koreyoshi-zzz/CRTC2026-SuiYuan/media/README.md

# 媒体素材

本目录存放考核演示视频。文档 `docs/CRTC2026_中期考核技术文档.md` 第 5 章的各功能板块通过相对路径引用本目录文件。

## 当前文件

| 文件名 | 内容说明 | 分辨率 | 帧率 | 时长 | 大小 | 是否达标 |
| --- | --- | --- | --- | --- | --- | --- |
| `chassis_ps2.mp4` | PS2 手柄遥控底盘（5.6 底盘运动） | 1920×1080 | 30 fps | 12.8 s | 13.6 MB | ✅ 达标 |
| `drop_test.mp4` | 180 mm 自由落体跌落测试（5.11 结构稳定性） | 2560×1440 | 120 fps | 20.9 s | 44.6 MB | ✅ 达标 |
| `appearance_360.mp4` | 整车外形展示 / 绕车一周（5.1） | 1584×720 | 25 fps | 10.0 s | 4.5 MB | ⚠️ 720p/25fps |
| `servo_demo.mp4` | 舵机运动演示（5.4 单一 / 5.5 多项共用） | 1584×720 | 25 fps | 14.9 s | 5.9 MB | ⚠️ 720p/25fps |
| `demo_servo_mechanism_1.mp4` | 舵机执行机构想法演示 1（2.3 机构想法） | 1280×720 | 30 fps | 10.9 s | 1.0 MB | ⚠️ 720p |
| `demo_servo_mechanism_2.mp4` | 舵机执行机构想法演示 2（2.3 机构想法） | 1280×720 | 30 fps | 6.7 s | 0.4 MB | ⚠️ 720p |
| `pcb_demo.mp4` | PCB 与底板工艺演示（3.4） | — | — | — | 0.6 MB | 过程素材 |

> ⚠️ **规格提醒**：`appearance_360.mp4` 与 `servo_demo.mp4` 当前为 **1584×720 / 25 fps**，
> 低于手册要求的 **1080p / ≥30 fps**。这是社交软件转发后的压缩版本，
> 若能从手机相册取得原始拍摄文件，请**同名覆盖**这两个文件，文档无需改动。
>
> `demo_servo_mechanism_*.mp4` 同为 720p，仅作机构想法参考，不作为正式考核视频。

## 待补充视频

| 对应指标 | 文件名（约定） | 内容要求 |
| --- | --- | --- |
| 5.2 电机运动（单一） | `motor_single.mp4` | 单个电机正反转 |
| 5.3 电机运动（全部） | `motor_all.mp4` | 4 个电机同时转动 |

> 5.1 外形展示、5.4 / 5.5 舵机运动已由 `appearance_360.mp4`、`servo_demo.mp4` 覆盖。

## 提交规范（手册「材料提交方式」）

- 视频格式 **`.mp4`**，清晰度 **≥1080p**，帧率 **≥30 fps**；
- 所有视频打包为**一个 `.zip`**，命名格式 **「实训战队名称＋队伍名称＋队长姓名」**；
- 本队对应文件名：**`GSing随缘张川.zip`**（作为邮件附件提交，不放入仓库，避免视频重复占用空间）；
- 邮件主题：**「随缘 张川」**，正文罗列完成指标并附仓库地址。
