koreyoshi-zzz/CRTC2026-SuiYuan/mechanical/README.md

# 机械结构

本目录存放机器人机械零部件的 STEP 模型文件，可在 Fusion 360 / SolidWorks 等 CAD 软件中打开。

## 零件清单

| 文件名 | 说明 |
| --- | --- |
| 零部件7.step | 底盘 / 机架相关零件 |
| 零部件8.step | 底盘 / 机架相关零件 |
| 零部件9.step | 底盘 / 机架相关零件 |
| 零部件10.step | 底盘 / 机架相关零件 |
| 零部件13.step | 执行机构 / 夹爪相关零件 |
| 零部件16.step | 执行机构 / 夹爪相关零件 |
| 零部件17.step | 执行机构 / 夹爪相关零件 |
| 零部件18.step | 执行机构 / 夹爪相关零件 |
| 零部件19.step | 执行机构 / 夹爪相关零件 |

> 注：原始文件名来自导出时的默认命名，后续可在装配树中补充各零件的具体名称与作用。

## 加工方式

- 底盘：金属折弯板（官方物资表）
- 支架 / 外壳 / 携带机构：PETG 材质 3D 打印（京东商家加工）
- 紧固：螺丝紧固，未使用热熔胶
