koreyoshi-zzz/CRTC2026-SuiYuan/pcb/CRTC_copy_schematic.pdf

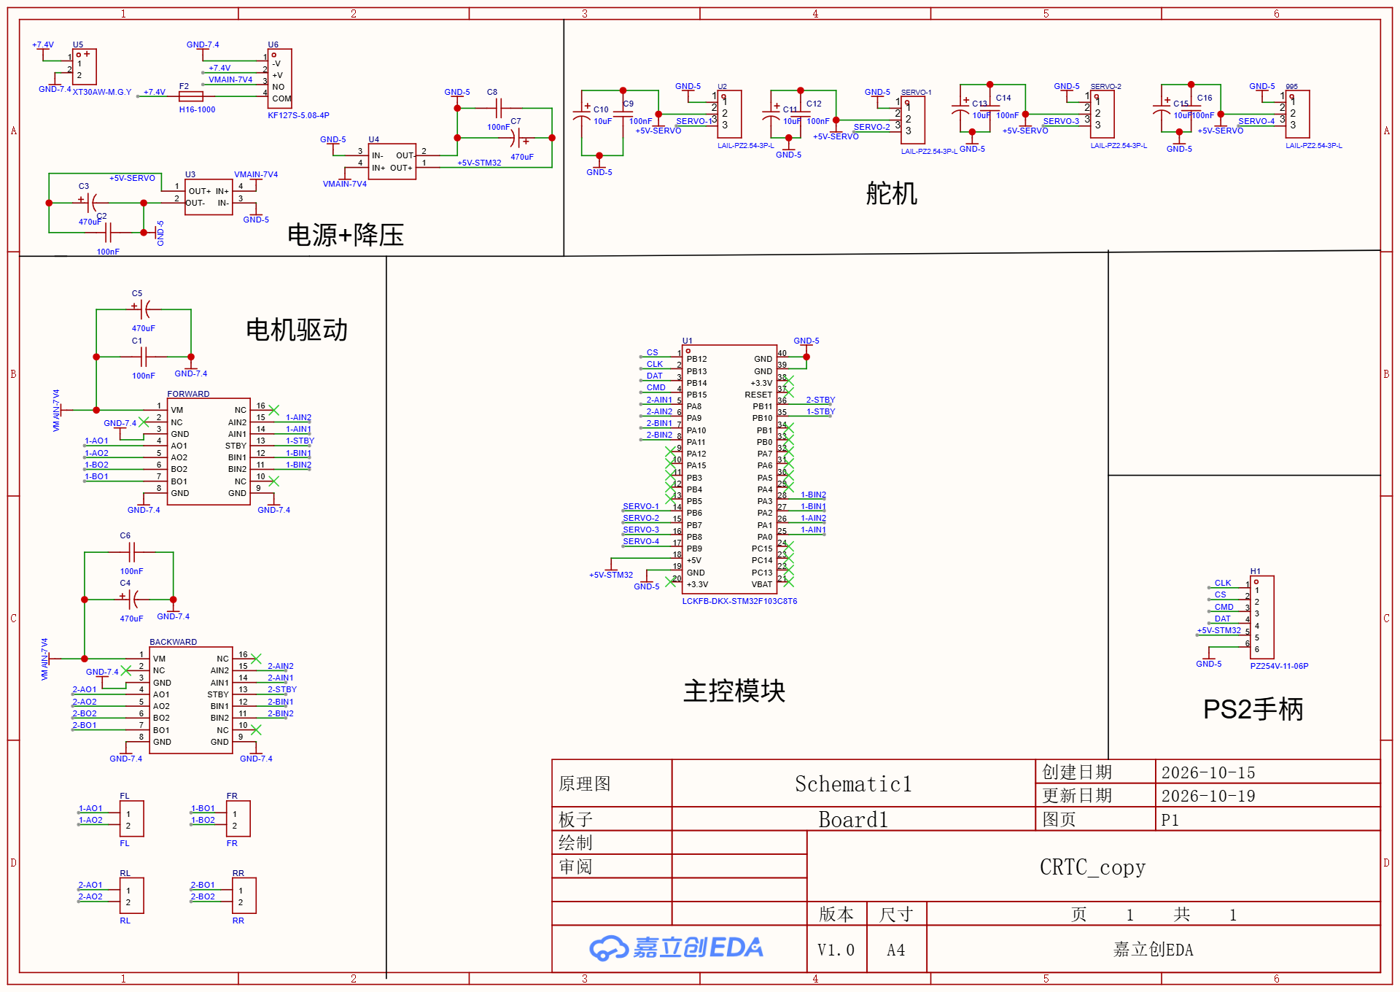
[picture p13: page 1]
