koreyoshi-zzz/CRTC2026-SuiYuan/mechanical/parts/零部件7.step

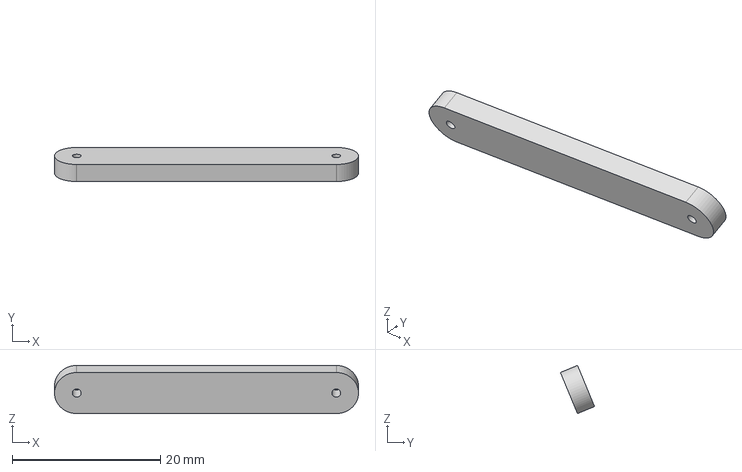
[picture p14: CAD file, 2026-10-19]
mechanical/parts/零部件7.step
41.0 x 4.61 x 6.50 mm
