koreyoshi-zzz/CRTC2026-SuiYuan/mechanical/parts/零部件18.step

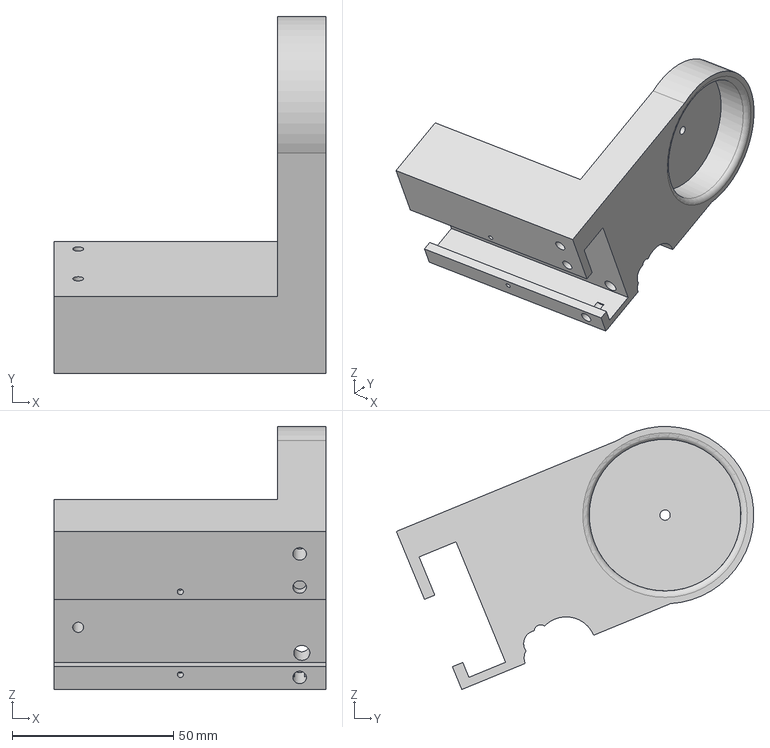
[picture p15: CAD file, 2026-10-19]
mechanical/parts/零部件18.step
84.3 x 110.8 x 81.6 mm
