koreyoshi-zzz/CRTC2026-SuiYuan/mechanical/parts/零部件19.step

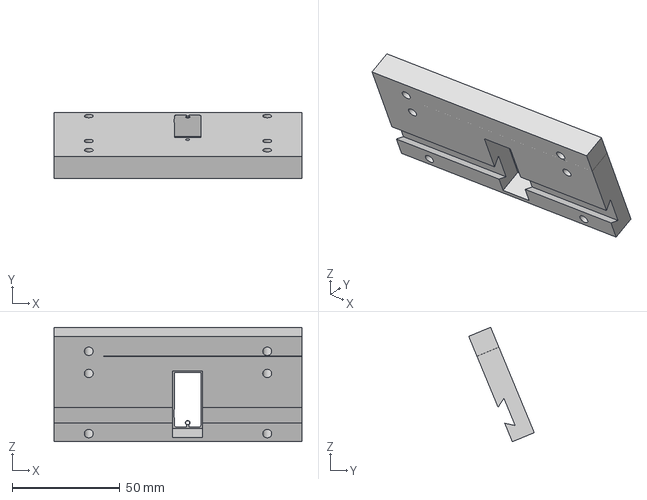
[picture p16: CAD file, 2026-10-19]
mechanical/parts/零部件19.step
115.3 x 30.5 x 53.2 mm
