koreyoshi-zzz/CRTC2026-SuiYuan/mechanical/parts/零部件17.step

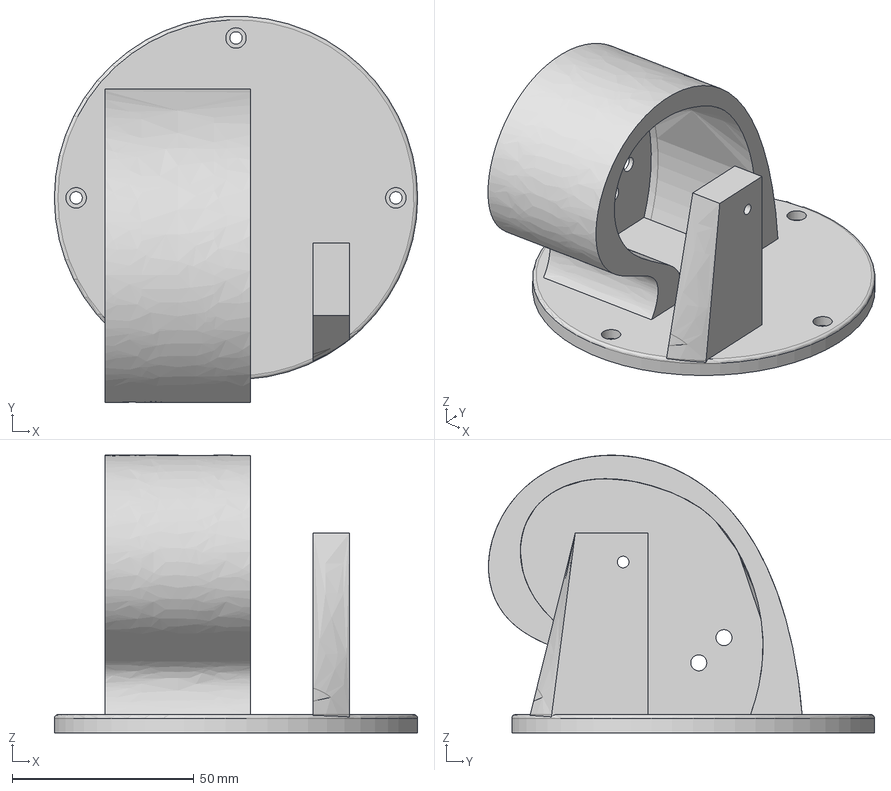
[picture p17: CAD file, 2026-10-19]
mechanical/parts/零部件17.step
100.0 x 106.2 x 76.4 mm
