koreyoshi-zzz/CRTC2026-SuiYuan/mechanical/parts/零部件10.step

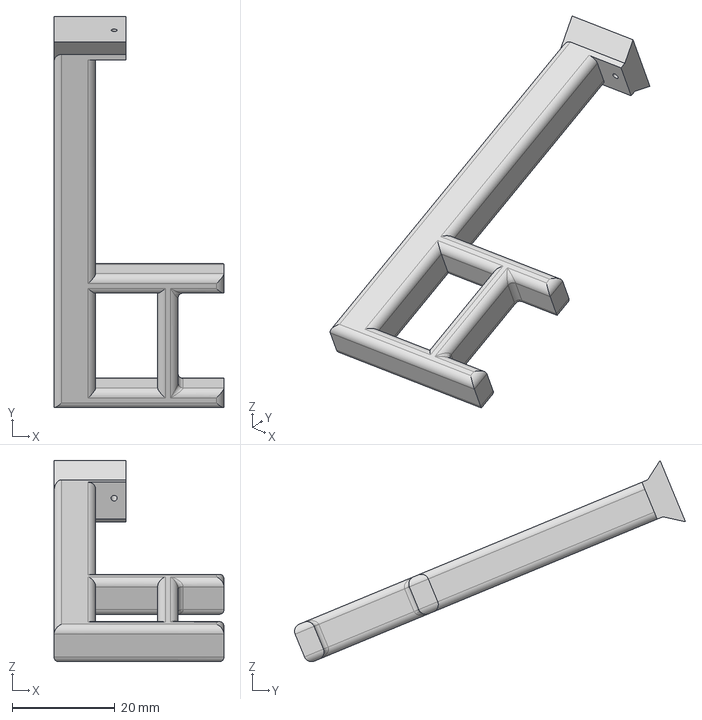
[picture p18: CAD file, 2026-10-19]
mechanical/parts/零部件10.step
33.1 x 76.2 x 39.2 mm
