koreyoshi-zzz/CRTC2026-SuiYuan/mechanical/parts/零部件9.step

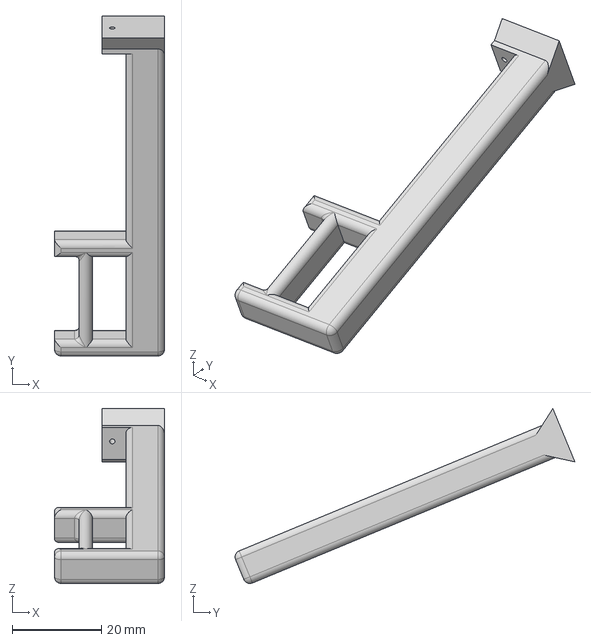
[picture p19: CAD file, 2026-10-19]
mechanical/parts/零部件9.step
24.7 x 76.2 x 39.2 mm
