koreyoshi-zzz/CRTC2026-SuiYuan/mechanical/parts/零部件16.step

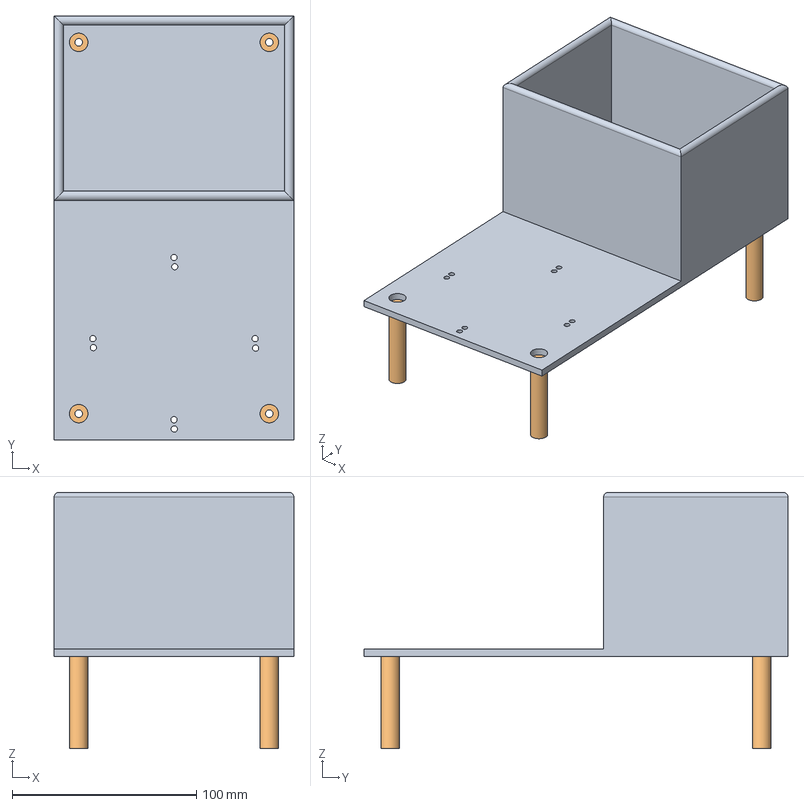
[picture p20: CAD file, 2026-10-19]
mechanical/parts/零部件16.step
130.0 x 230.0 x 139.0 mm
