koreyoshi-zzz/CRTC2026-SuiYuan/mechanical/parts/零部件13.step

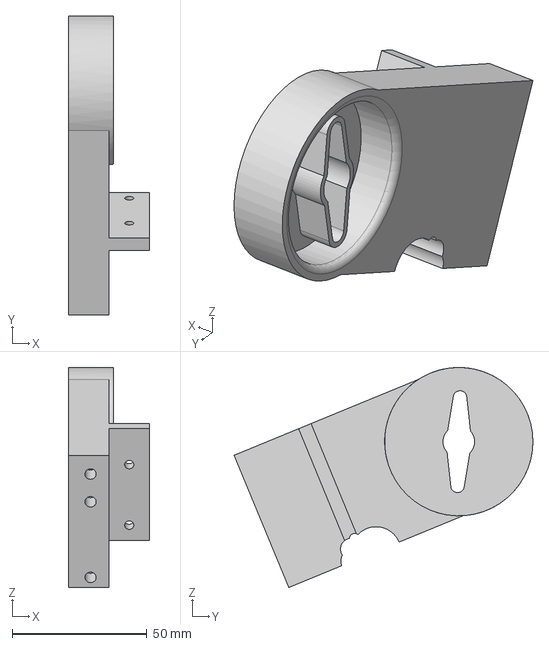
[picture p21: CAD file, 2026-10-19]
mechanical/parts/零部件13.step
30.0 x 110.8 x 81.6 mm
