koreyoshi-zzz/CRTC2026-SuiYuan/mechanical/parts/零部件8.step

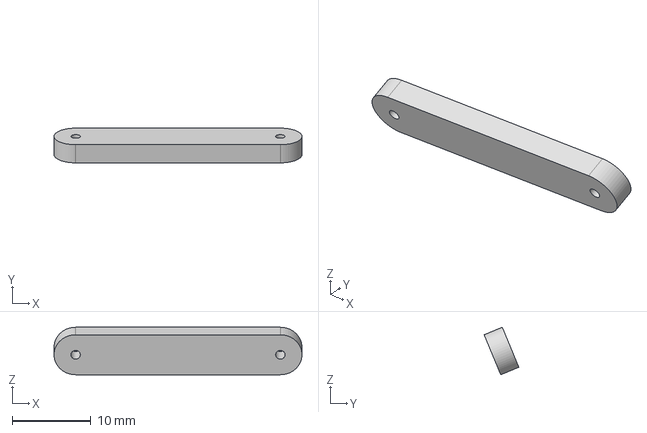
[picture p22: CAD file, 2026-10-19]
mechanical/parts/零部件8.step
31.5 x 4.41 x 6.04 mm
