koreyoshi-zzz/CRTC2026-SuiYuan/firmware/CRTC_CAR/CRTC_CAR.ioc

Mcu.UserName=STM32F103C8Tx
PA0-WKUP.Signal=S_TIM2_CH1
PA1.Signal=S_TIM2_CH2
PA10.Signal=S_TIM1_CH3
PA11.Signal=S_TIM1_CH4
PA13.Signal=SYS_JTMS-SWDIO
PA14.Signal=SYS_JTCK-SWCLK
PA2.Signal=S_TIM2_CH3
PA3.Signal=S_TIM2_CH4
PA8.Signal=S_TIM1_CH1
PA9.Signal=S_TIM1_CH2
PB12.GPIO_Label=PS2_CS
PB12.Signal=GPIO_Output
PB13.GPIO_Label=PS2_CLK
PB13.Signal=GPIO_Output
PB14.GPIO_Label=PS2_DAT
PB14.Signal=GPIO_Input
PB15.GPIO_Label=PS2_CMD
PB15.Signal=GPIO_Output
PB5.GPIO_Label=RELAY
PB5.Signal=GPIO_Output
PB6.Signal=S_TIM4_CH1
PB7.Signal=S_TIM4_CH2
PB8.Signal=S_TIM4_CH3
PC13-ANTI_TAMP.GPIO_Label=LED
PC13-ANTI_TAMP.Signal=GPIO_Output
PD0-OSC_IN.Signal=RCC_OSC_IN
PD1-OSC_OUT.Signal=RCC_OSC_OUT
