koreyoshi-zzz/CRTC2026-SuiYuan/firmware/CRTC_CAR/Core/Inc/main.h

#define PS2_CS_Pin GPIO_PIN_12
#define PS2_CS_GPIO_Port GPIOB
#define PS2_CLK_Pin GPIO_PIN_13
#define PS2_CLK_GPIO_Port GPIOB
#define PS2_DAT_Pin GPIO_PIN_14
#define PS2_DAT_GPIO_Port GPIOB
#define PS2_CMD_Pin GPIO_PIN_15
#define PS2_CMD_GPIO_Port GPIOB
#define RELAY_Pin GPIO_PIN_5
#define RELAY_GPIO_Port GPIOB
#define LED_Pin GPIO_PIN_13
#define LED_GPIO_Port GPIOC
