koreyoshi-zzz/CRTC2026-SuiYuan/firmware/CRTC_CAR/Core/Inc/debug_motor.h

/*
 * debug_motor.h
 *
 *  Created on: 2026年10月19日
 *      Author: zc
 *
 *  电机独立调试程序（麦克纳姆轮底盘）。
 *  接线：FL=PA0/PA1，FR=PA2/PA3（TIM2）；RL=PA8/PA9，RR=PA10/PA11（TIM1）
 */

#ifndef INC_DEBUG_MOTOR_H_
#define INC_DEBUG_MOTOR_H_

void Debug_Motor_Run(void);

#endif /* INC_DEBUG_MOTOR_H_ */
