koreyoshi-zzz/CRTC2026-SuiYuan/(commit log)

2026-10-19 CRTC2026 中期考核材料：技术文档、固件、机械模型、PCB、演示视频
    [零部件10.step, 零部件13.step, 零部件16.step, 零部件17.step, 零部件18.step, 零部件19.step, 零部件7.step, 零部件8.step]
2026-10-19 README: 移除结构树中的 README/.gitignore 条目
2026-10-19 移除 .gitignore
2026-11-10 恢复 .gitignore：忽略 70 MB 演示视频压缩包与构建产物
